Leduodeshok/MeteoStation/Rapports seances/Victor Girard/Choix_ville.jpg

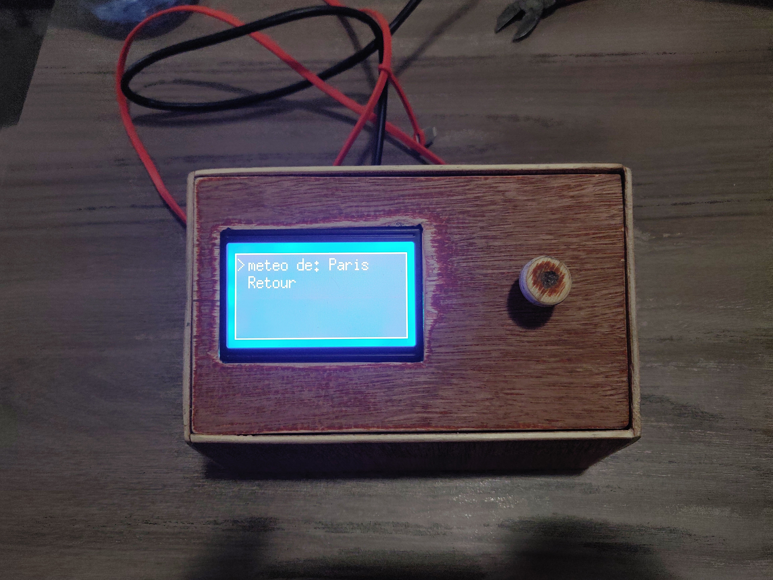
Rapports seances/Victor Girard/Choix_ville.jpg
