Leduodeshok/MeteoStation/Rapports seances/Victor Girard/ecran+dht seance1.jpg

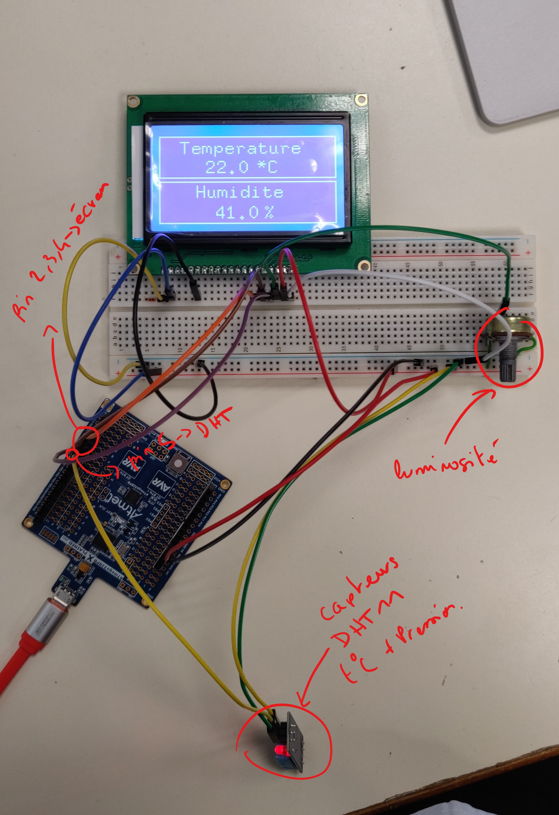
Rapports seances/Victor Girard/ecran+dht seance1.jpg
