Leduodeshok/MeteoStation/(list of files, cad)

Other CAD files:
RENDU3D/BOITIER INT v1.f3d
