Leduodeshok/MeteoStation/CODES/CODE_FINAL_ARD_INTERIEUR/display_menu.ino

// *********************************************************************
// FONCTIONS D'AFFICHAGE
// *********************************************************************


/* ******************************************************************** */
void lcdml_menu_clear()
/* ******************************************************************** */
{
}

/* ******************************************************************** */
void lcdml_menu_display()
/* ******************************************************************** */
{
  // for first test set font here
  u8g.setFont(_LCDML_DISP_font);
  //u8g.setColorIndex(1); // Instructs the display to draw with a pixel on.

  // declaration of some variables
  // ***************
  // content variable
  char content_text[_LCDML_DISP_cols];  // save the content text of every menu element
  // menu element object
  LCDMenuLib2_menu *tmp;
  // some limit values
  uint8_t i = LCDML.MENU_getScroll();
  uint8_t maxi = _LCDML_DISP_rows + i;
  uint8_t n = 0;

   // init vars
  uint8_t n_max             = (LCDML.MENU_getChilds() >= _LCDML_DISP_rows) ? _LCDML_DISP_rows : (LCDML.MENU_getChilds());

  uint8_t scrollbar_min     = 0;
  uint8_t scrollbar_max     = LCDML.MENU_getChilds();
  uint8_t scrollbar_cur_pos = LCDML.MENU_getCursorPosAbs();
  uint8_t scroll_pos        = ((1.*n_max * _LCDML_DISP_rows) / (scrollbar_max - 1) * scrollbar_cur_pos);


 // for first test set font here
  u8g.setFont(_LCDML_DISP_font);
  u8g.setColorIndex(1); // Instructs the display to draw with a pixel on.


  // generate content
  u8g.firstPage();
  do {


    n = 0;
    i = LCDML.MENU_getScroll();
    // update content
    // ***************

      // clear menu
      // ***************

    // check if this element has children
    if ((tmp = LCDML.MENU_getDisplayedObj()) != NULL)
    {
      // loop to display lines
      do
      {
        // check if a menu element has a condition and if the condition be true
        if (tmp->checkCondition())
        {
          // check the type off a menu element
          if(tmp->checkType_menu() == true)
          {
            // display normal content
            LCDML_getContent(content_text, tmp->getID());
            u8g.drawStr( _LCDML_DISP_box_x0+_LCDML_DISP_font_w + _LCDML_DISP_cur_space_behind, _LCDML_DISP_box_y0 + _LCDML_DISP_font_h * (n + 1), content_text);
          }
          else
          {
            if(tmp->checkType_dynParam()) {
              tmp->callback(n);
            }
          }
          // increment some values
          i++;
          n++;
        }
      // try to go to the next sibling and check the number of displayed rows
      } while (((tmp = tmp->getSibling(1)) != NULL) && (i < maxi));
    }

    // set cursor
    u8g.drawStr( _LCDML_DISP_box_x0+_LCDML_DISP_cur_space_before, _LCDML_DISP_box_y0 + _LCDML_DISP_font_h * (LCDML.MENU_getCursorPos() + 1),  _LCDML_DISP_cursor_char);

    if(_LCDML_DISP_draw_frame == 1) {
       u8g.drawFrame(_LCDML_DISP_box_x0, _LCDML_DISP_box_y0, (_LCDML_DISP_box_x1-_LCDML_DISP_box_x0), (_LCDML_DISP_box_y1-_LCDML_DISP_box_y0));
    }

    // display scrollbar when more content as rows available and with > 2
    if (scrollbar_max > n_max && _LCDML_DISP_scrollbar_w > 2)
    {
      // set frame for scrollbar
      u8g.drawFrame(_LCDML_DISP_box_x1 - _LCDML_DISP_scrollbar_w, _LCDML_DISP_box_y0, _LCDML_DISP_scrollbar_w, _LCDML_DISP_box_y1-_LCDML_DISP_box_y0);

      // calculate scrollbar length
      uint8_t scrollbar_block_length = scrollbar_max - n_max;
      scrollbar_block_length = (_LCDML_DISP_box_y1-_LCDML_DISP_box_y0) / (scrollbar_block_length + _LCDML_DISP_rows);

      //set scrollbar
      if (scrollbar_cur_pos == 0) {                                   // top position     (min)
        u8g.drawBox(_LCDML_DISP_box_x1 - (_LCDML_DISP_scrollbar_w-1), _LCDML_DISP_box_y0 + 1                                                     , (_LCDML_DISP_scrollbar_w-2)  , scrollbar_block_length);
      }
      else if (scrollbar_cur_pos == (scrollbar_max-1)) {            // bottom position  (max)
        u8g.drawBox(_LCDML_DISP_box_x1 - (_LCDML_DISP_scrollbar_w-1), _LCDML_DISP_box_y1 - scrollbar_block_length                                , (_LCDML_DISP_scrollbar_w-2)  , scrollbar_block_length);
      }
      else {                                                                // between top and bottom
        u8g.drawBox(_LCDML_DISP_box_x1 - (_LCDML_DISP_scrollbar_w-1), _LCDML_DISP_box_y0 + (scrollbar_block_length * scrollbar_cur_pos + 1),(_LCDML_DISP_scrollbar_w-2)  , scrollbar_block_length);
      }
    }
  } while ( u8g.nextPage() );
}
