Leduodeshok/MeteoStation/CODES/CODE_FINAL_ARD_INTERIEUR/condition.ino

// *********************************************************************
// CONDITION D4AFFICHAGE OU NON D'UN ELEMENT A L'ECRAN
// *********************************************************************

boolean COND_hide()  //cache un element menu
{
  return false;  // caché
}
