Leduodeshok/MeteoStation/(commit log)

2019-02-06 Code de l'API pour récupérer les infos et les triers
2019-02-27 Create Cachier des charges
2019-03-20 Add files via upload
    Module de traitement de la reception des chaines de caractères venant de l'esp ou de l'arduino extérieur.
    module présent sur l'arduino intérieure.
2019-03-20 Rename CODES/Programme complet des éléments extérieurs/code_AGHT to CODES/CODE_FINAL_ARD_EXTERIEUR/code_AGHT.ino
